terryjmyers/4-20mA-Data-Logger.ino/2016-12-26 17.29.07.jpg

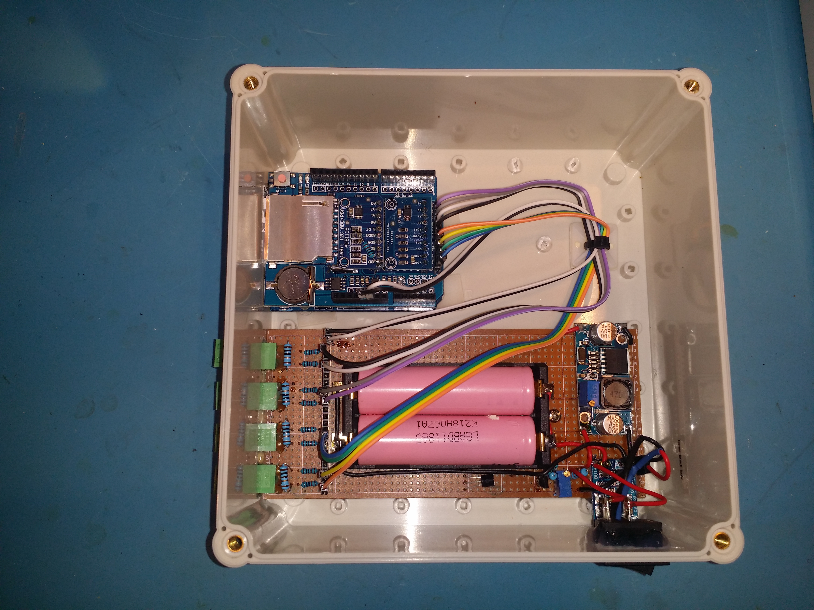
2016-12-26 17.29.07.jpg
