terryjmyers/4-20mA-Data-Logger.ino/2016-12-27 11.09.25.jpg

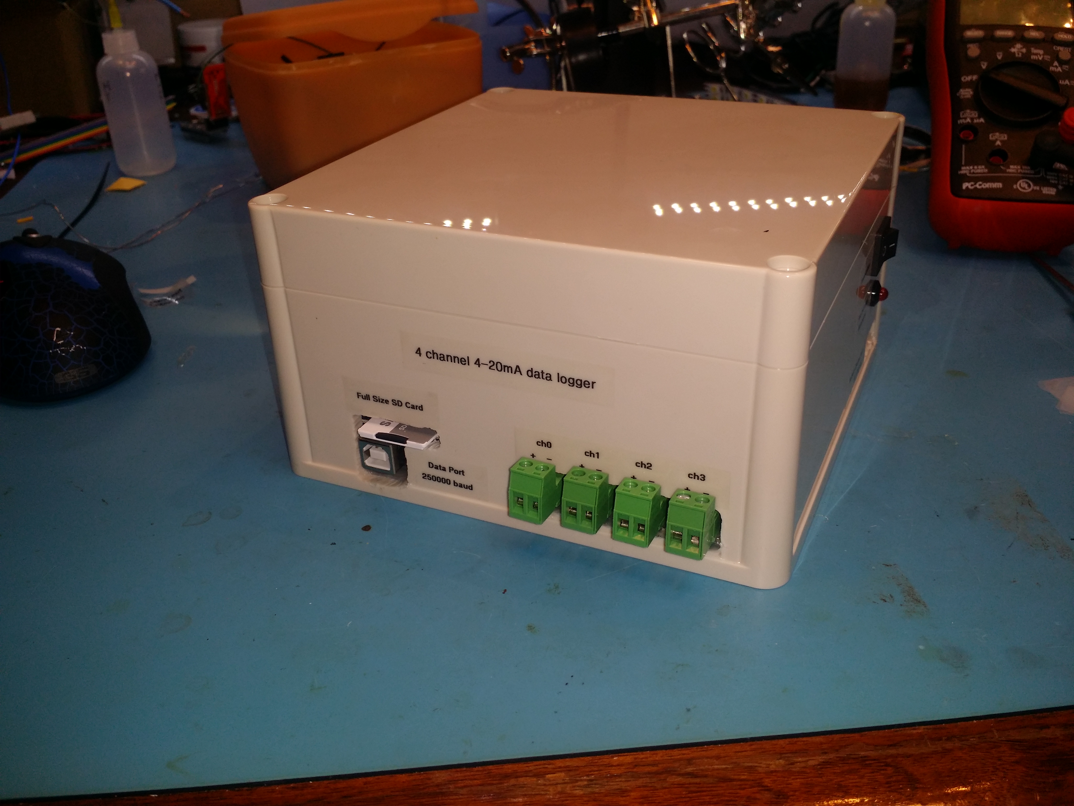
2016-12-27 11.09.25.jpg
