terryjmyers/4-20mA-Data-Logger.ino/_4-20mA_Data_Logger_Schematic.pdf

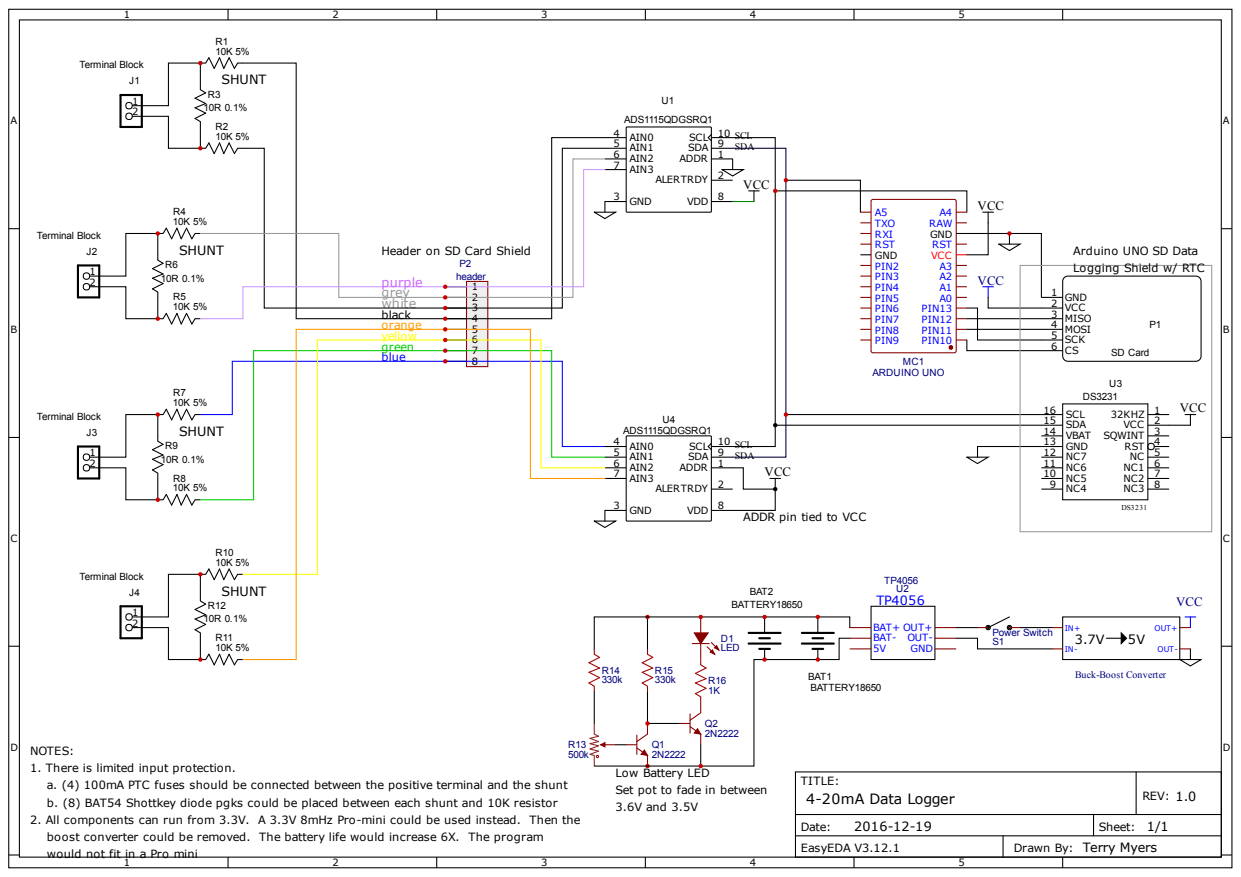
[picture p4: page 1]

Header on SD Card Shield

Arduino UNO SD Data
Logging Shield w/ RTC

green 7
blue

ADDR pin tied to VCC

NOTES:
1. There is limited input protection.
a. (4) 100mA PTC fuses should be connected between the positive terminal and the shunt
b. (8) BAT54 Shottkey diode pgks could be placed between each shunt and 10K resistor
2. All components can run from 3.3V. A 3.3V 8mHz Promini could be used instead. Then the
boost converter could be removed. The battery life would increase 6X. The program
would not fit in a Pro mini

Low Battery LED
Set pot to fade in between
3.6V and 3.5V
